Jiangjia2036/star-forged-instruments/Circuit Diagram/Circuit Schematic.png

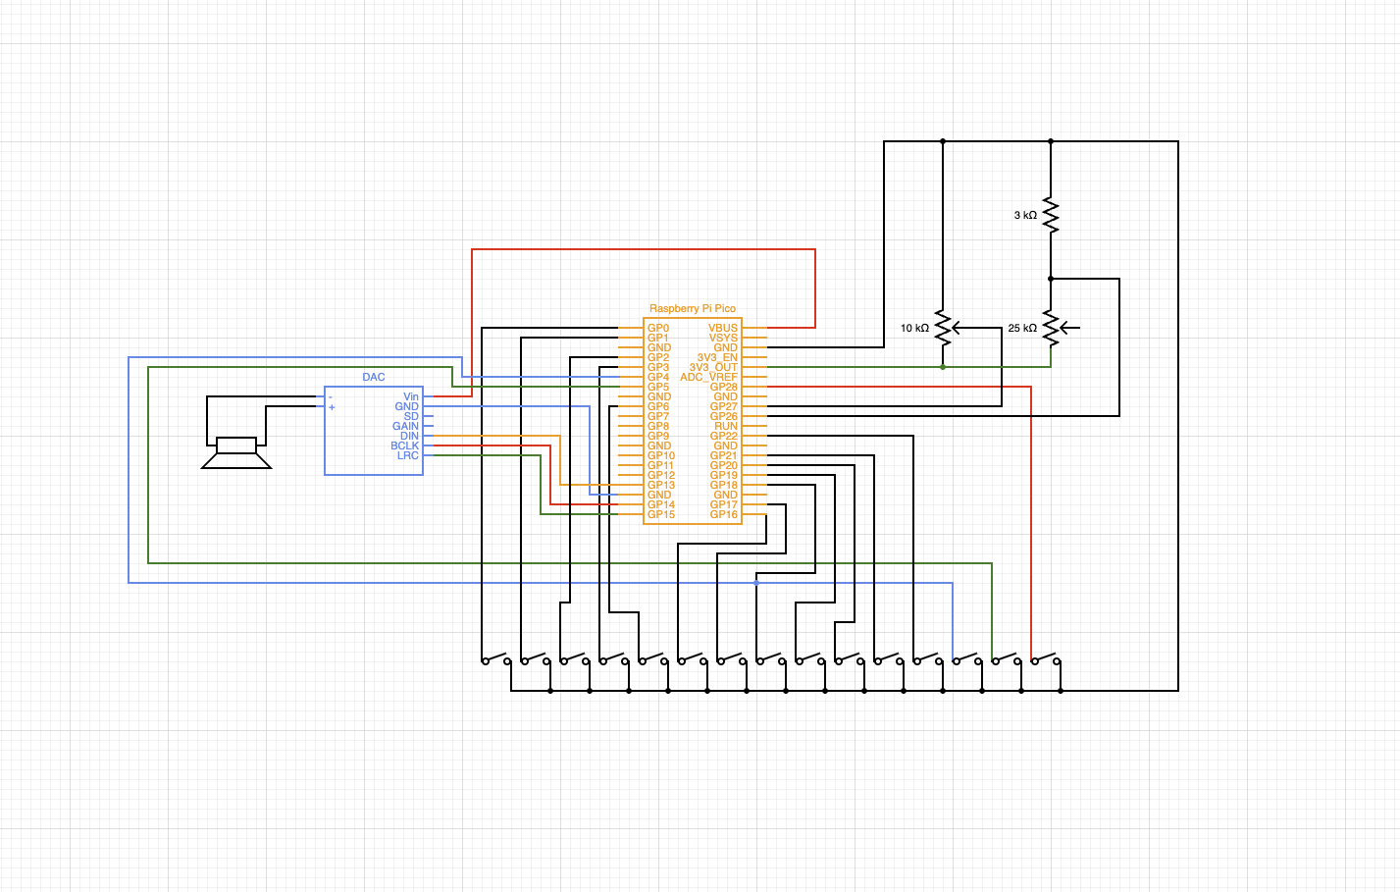
Circuit Diagram/Circuit Schematic.png
