Jiangjia2036/star-forged-instruments/CAD/Button Assembly.stl

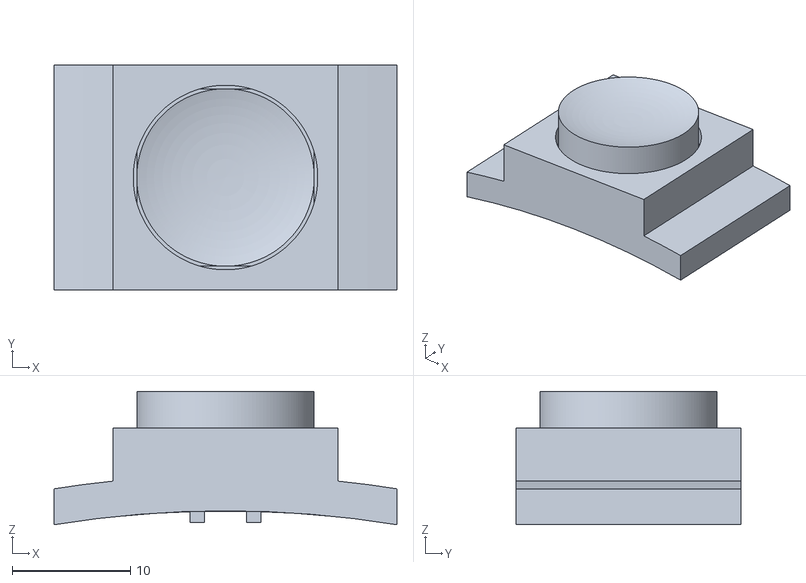
[picture p2: CAD file, 2026-08-11]
CAD/Button Assembly.stl
29.0 x 19.0 x 11.3
