Jiangjia2036/star-forged-instruments/CAD/HexNut_CalibrationTest.stl

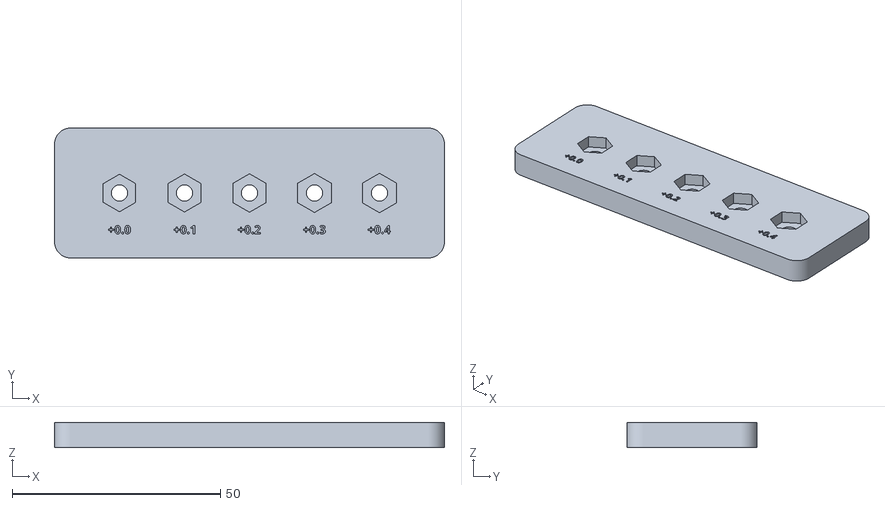
[picture p3: CAD file, 2026-08-11]
CAD/HexNut_CalibrationTest.stl
93.6 x 31.2 x 6.00
