Jiangjia2036/star-forged-instruments/CAD/ButtonSwitch_Model.stl

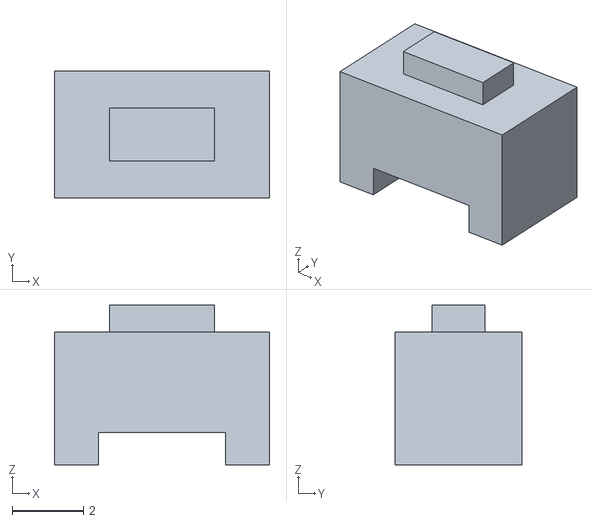
[picture p4: CAD file, 2026-08-11]
CAD/ButtonSwitch_Model.stl
6.02 x 3.55 x 4.47
