Jiangjia2036/star-forged-instruments/CAD/KeyTest_V0.stl

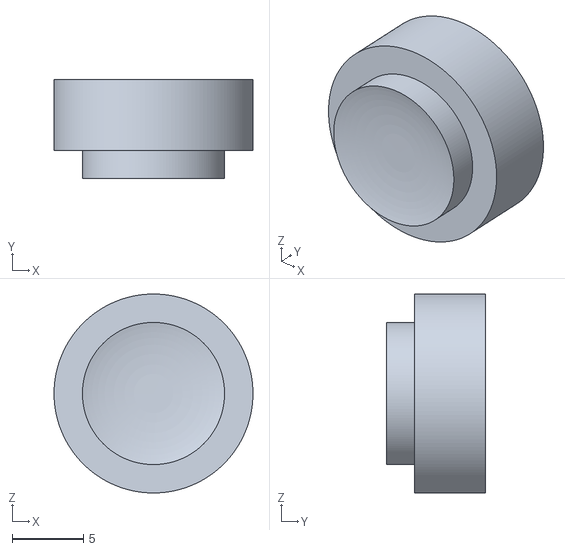
[picture p5: CAD file, 2026-08-11]
CAD/KeyTest_V0.stl
14.0 x 7.00 x 14.0
