Jiangjia2036/star-forged-instruments/CAD/ButtonSocket_Test.stl

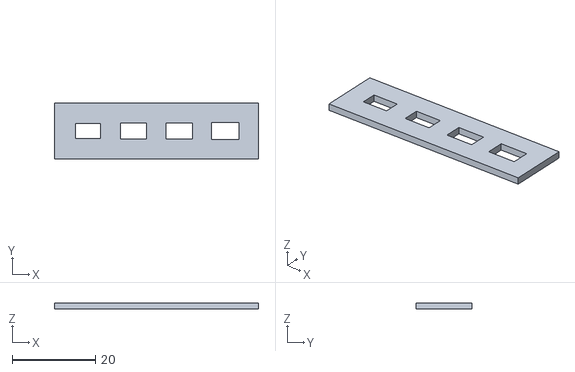
[picture p6: CAD file, 2026-08-11]
CAD/ButtonSocket_Test.stl
49.1 x 13.6 x 1.50
