Jiangjia2036/star-forged-instruments/CAD/Laser Cut Layered Curves.dxf

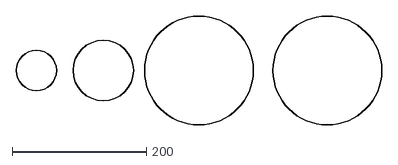
[picture p7: CAD file, 2026-08-11]
CAD/Laser Cut Layered Curves.dxf
543.8 x 161.9
