Jiangjia2036/star-forged-instruments/CAD/Slider_Model.stl

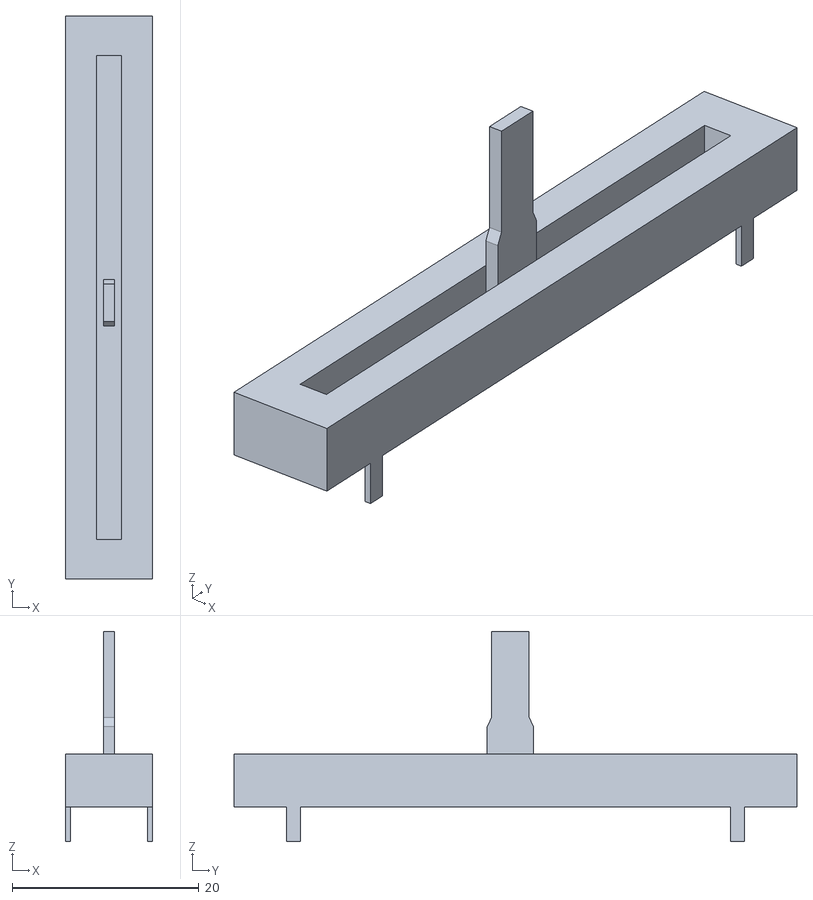
[picture p8: CAD file, 2026-08-11]
CAD/Slider_Model.stl
9.30 x 60.3 x 22.5
