Jiangjia2036/star-forged-instruments/CAD/UFO Prototype 3.stl

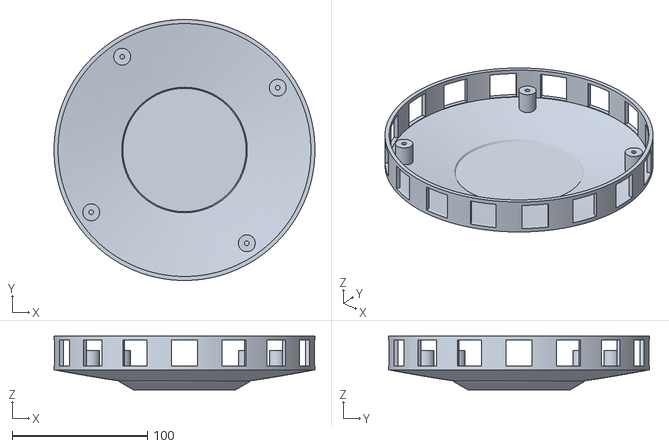
[picture p9: CAD file, 2026-08-11]
CAD/UFO Prototype 3.stl
193.0 x 193.0 x 39.8
