Jiangjia2036/star-forged-instruments/CAD/Partial UFO Wall.stl

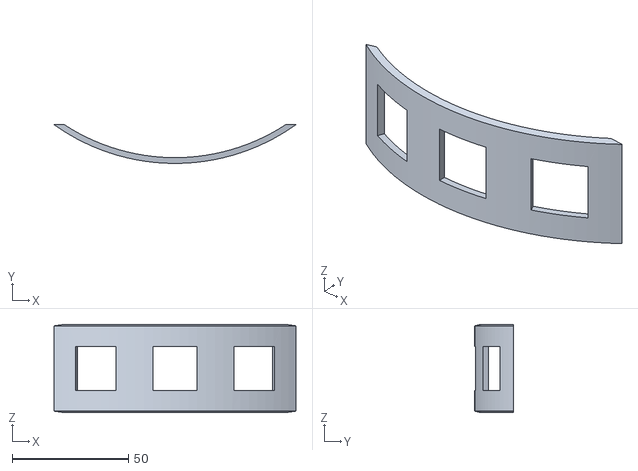
[picture p10: CAD file, 2026-08-11]
CAD/Partial UFO Wall.stl
104.1 x 16.7 x 38.0
