Jiangjia2036/star-forged-instruments/CAD/Logo on Lid.stl

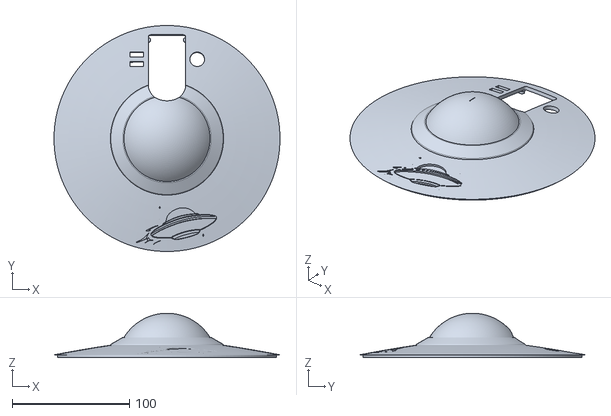
[picture p11: CAD file, 2026-08-11]
CAD/Logo on Lid.stl
193.0 x 193.0 x 38.0
