Jiangjia2036/star-forged-instruments/CAD/Speaker_Model.stl

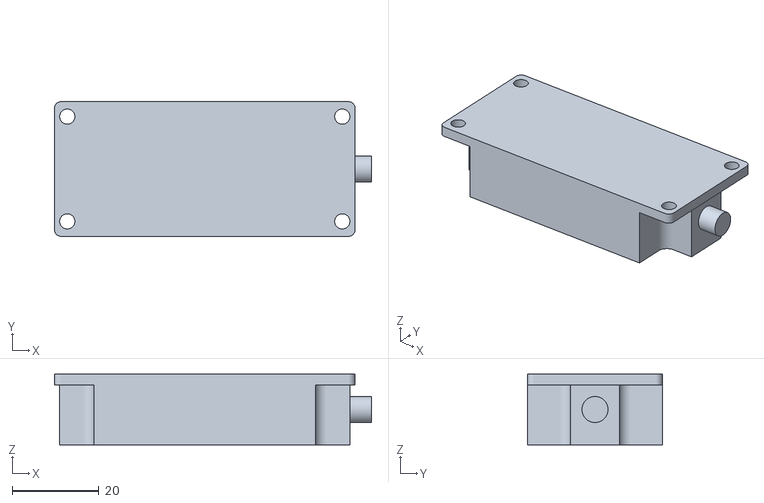
[picture p12: CAD file, 2026-08-11]
CAD/Speaker_Model.stl
73.2 x 31.1 x 16.3
