Jiangjia2036/star-forged-instruments/CAD/KeyCap_Snapon.stl

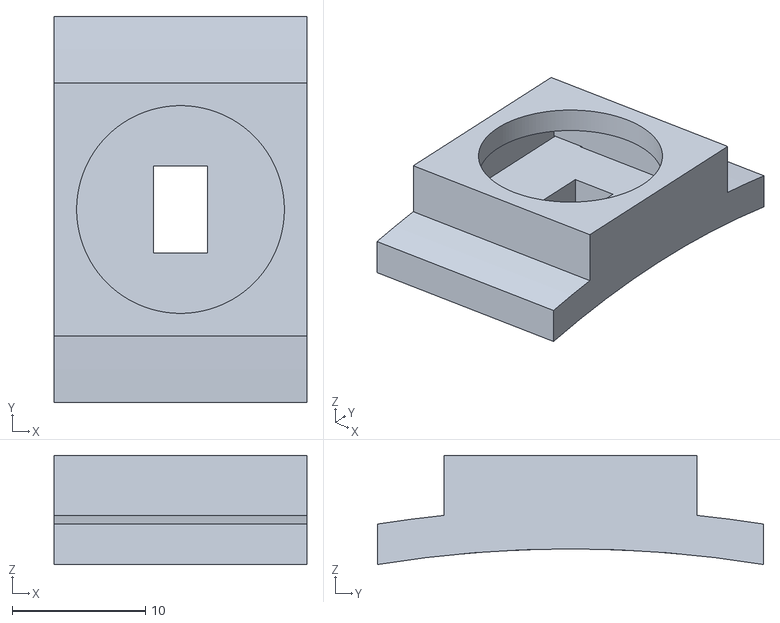
[picture p13: CAD file, 2026-08-11]
CAD/KeyCap_Snapon.stl
19.0 x 29.0 x 8.19
