Jiangjia2036/star-forged-instruments/CAD/Overhang_Test.stl

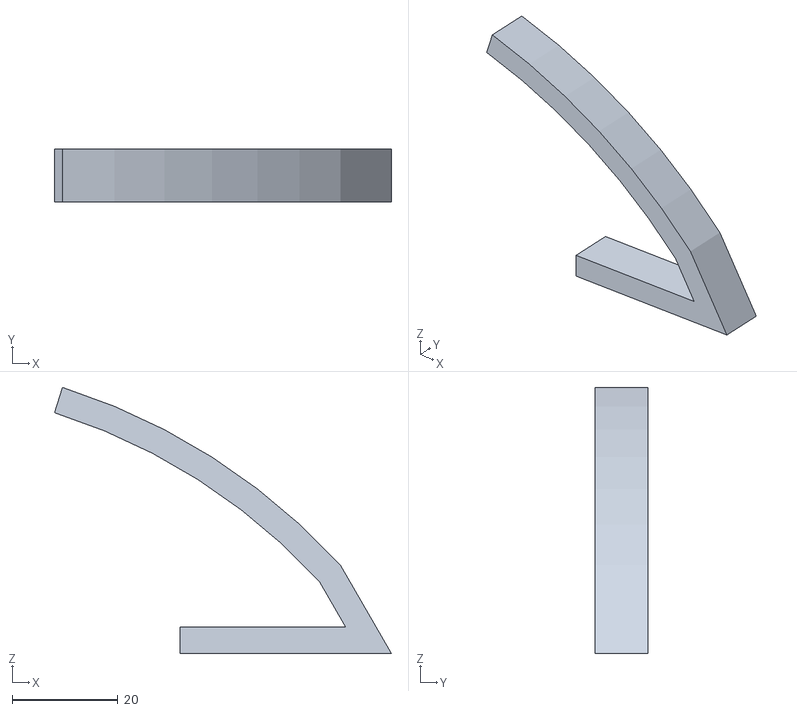
[picture p14: CAD file, 2026-08-11]
CAD/Overhang_Test.stl
63.7 x 10.0 x 50.3
