Jiangjia2036/star-forged-instruments/CAD/newKeyCap.stl

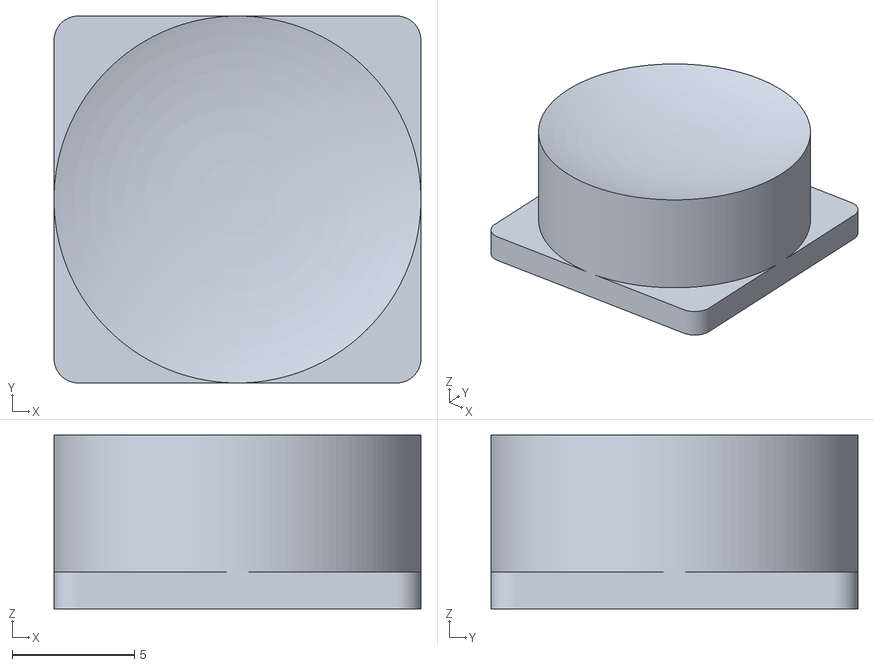
[picture p15: CAD file, 2026-08-11]
CAD/newKeyCap.stl
15.0 x 15.0 x 7.10
