Jiangjia2036/star-forged-instruments/CAD/BackBoneRingTest.stl

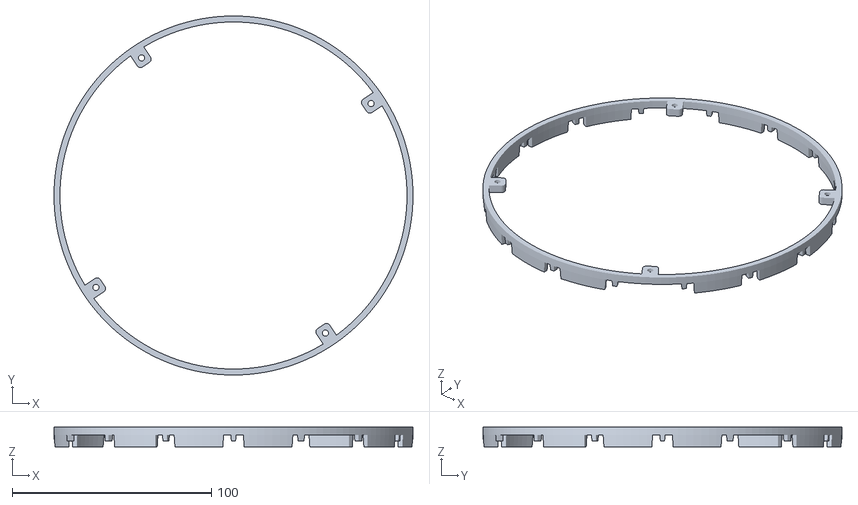
[picture p16: CAD file, 2026-08-11]
CAD/BackBoneRingTest.stl
180.0 x 180.0 x 10.0
