Jiangjia2036/star-forged-instruments/CAD/UFO Prototype 2.stl

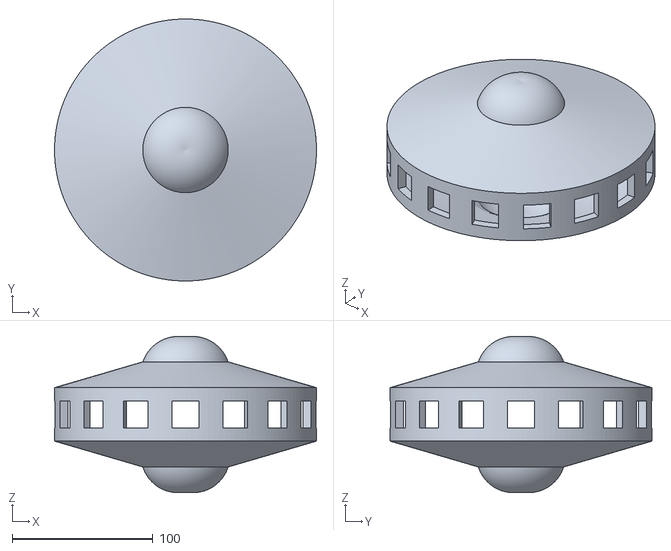
[picture p17: CAD file, 2026-08-11, an earlier design]
CAD/UFO Prototype 2.stl
186.2 x 186.2 x 111.0
