Jiangjia2036/star-forged-instruments/CAD/UFO Prototype 1.stl

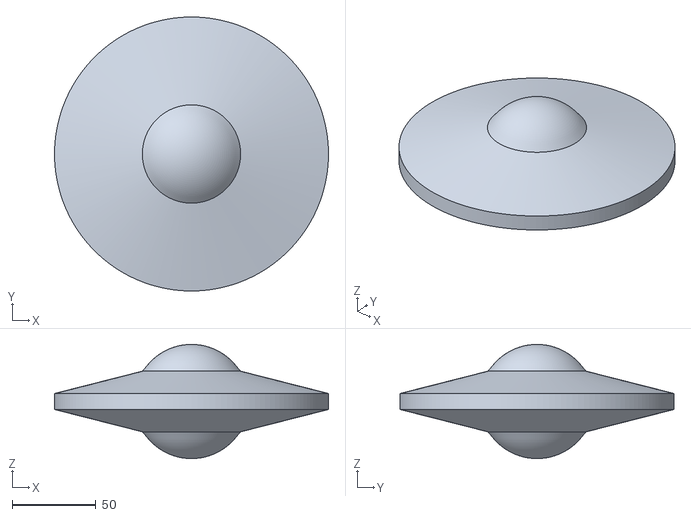
[picture p18: CAD file, 2026-08-11, an earlier design]
CAD/UFO Prototype 1.stl
164.0 x 164.0 x 68.3
