Jiangjia2036/star-forged-instruments/(commit log)

2026-08-08 3 buttons for notes, echo switch, bendy modulator, volume pot, speaker, amp
2026-08-08 Initial Testing for the button
2026-08-08 Tried adding the button to pico mechanism - Not Working
2026-08-08 Add Pico DSP engine and harden Web Serial connection
2026-08-08 Added where when u press the button the site also shows the note played
2026-08-08 Added the feature where if you press the physical button it gets shown on the keyboard on the site. Another feature added is where if you play a song on the site a progress bar is shown and the notes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
2026-08-08 User can run an audio file from the web onto the speaker connected to the micropico. The buttons can also overlap on top of the audio played
2026-08-08 Add Pico backing-track playback and hardware diagnostics
2026-08-08 added the slider on the website where if you change the volume through the potentiemeter if changes it on the website ad well. the website is more reactive to the buttons played and I tried fixing th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
    [main.py]
2026-08-09 Trying to fix it where when playing 2 notes the audion should be clean but not working
    [audio_test.py, button_test.py, code.py, config.py, inputs.py, main.py, serial_link.py, synth_engine.py]
2026-08-09 Further attempts at trying to fix the vocal track, also added names to the website, added another button to the algorithim as well.
    [audio_test.py, code.py, config.py, effects.py, inputs.py, synth_engine.py, waveforms.py]
2026-08-09 Added another two buttons to the site and the circuit
2026-08-09 Fixed the audio issue
    [code.py, config.py, synth_engine.py]
2026-08-09 Add MP3 backing-track support for Pico
2026-08-09 Added the flex sensor where it plays an alien noise. also made it to where the buttons are a better sounding. added the site as well so it plays 3 tracks and I deleted the dark horse by Katy Perry an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
    [code.py, config.py, effects.py, inputs.py, synth_engine.py]
2026-08-09 Simplify song playback and document flex sensor calibration
    [config.py]
2026-08-09 Fixed socket issue due to buggy features related to the mirroring
    [main.py]
2026-08-09 fixed button inputs and added a couple more
    [config.py]
2026-08-09 added site change where when you play a track the keyboard changes along with it.
2026-08-09 Added more buttons to the site and changed it to be more reactive with the website it should be now where with the physical instrument is matches each button in order from how they appear to the keyb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
2026-08-09 Fixed the echo bug where when you would use the physical switch it wasnt turning off or on
    [code.py]
2026-08-11 Added CAD files as STL files
    [BackBoneRingTest.stl, Button Assembly.stl, ButtonSocket_Test.stl, ButtonSwitch_Model.stl, HexNut_CalibrationTest.stl, KeyCap_Snapon.stl, KeyTest_V0.stl, Laser Cut Layered Curves.dxf]
2026-08-11 Added circuit Diagram and changed CAD Files Folders
    [BackBoneRingTest.stl, Button Assembly.stl, ButtonSocket_Test.stl, ButtonSwitch_Model.stl, HexNut_CalibrationTest.stl, KeyCap_Snapon.stl, KeyTest_V0.stl, Laser Cut Layered Curves.dxf]
